MRFIRE5673/ESP32-C3-Gamepad/docs/images/game_flappy_alt.jpg

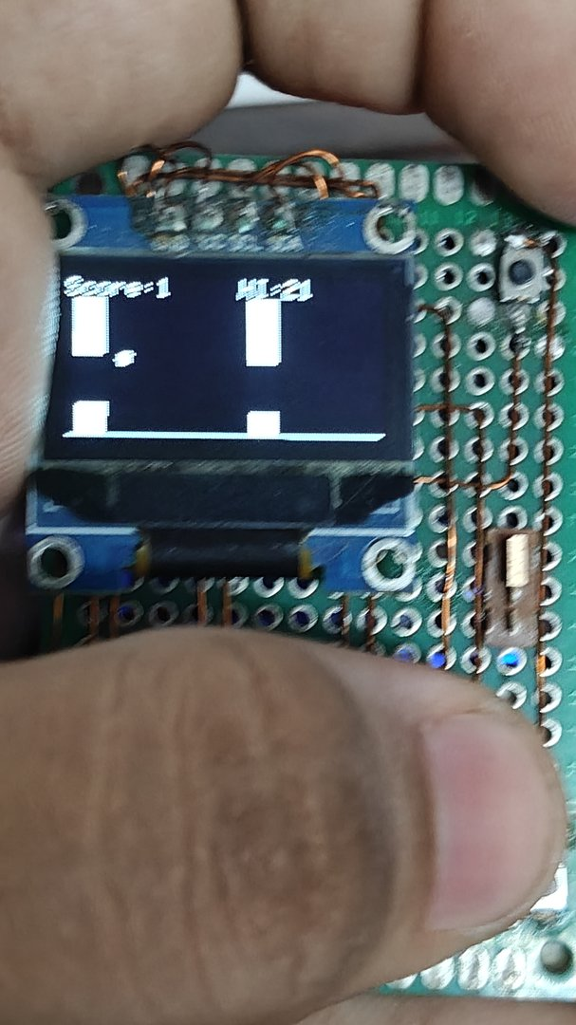
docs/images/game_flappy_alt.jpg
