MRFIRE5673/ESP32-C3-Gamepad/docs/images/settings_page2.jpg

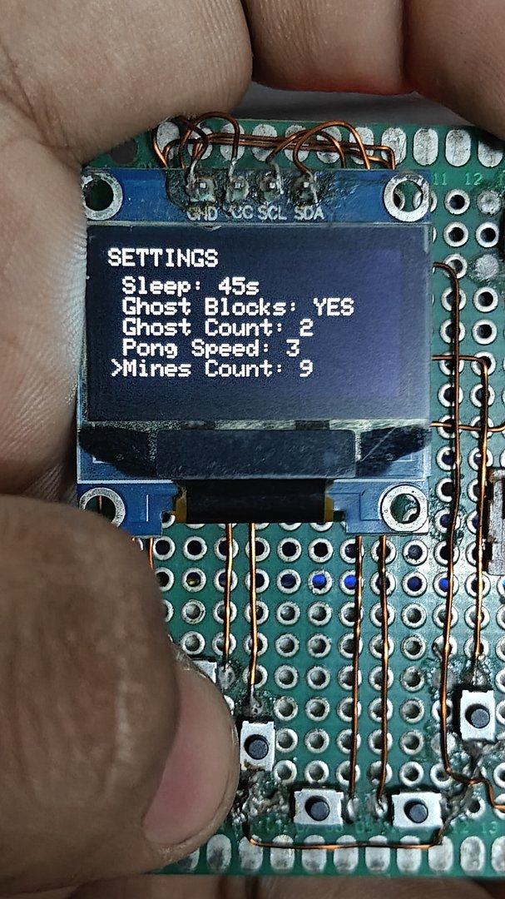
docs/images/settings_page2.jpg
